toriverly/CS207Project/img/hilt_wiring.jpg

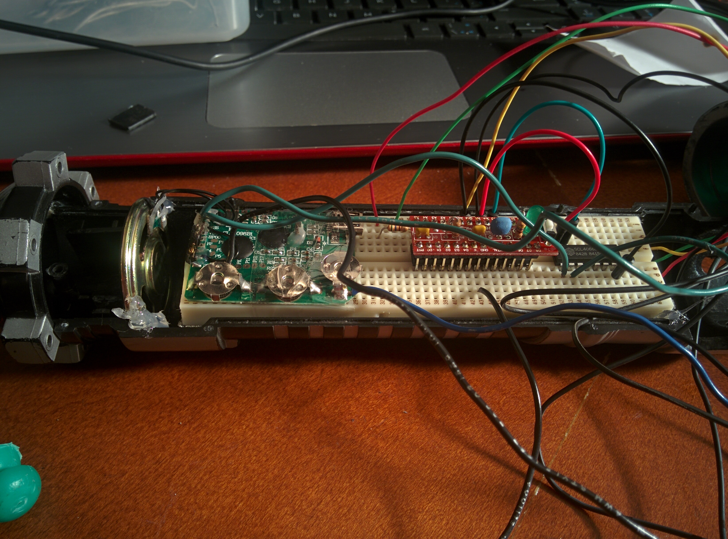
img/hilt_wiring.jpg
