toriverly/CS207Project/(commit log)

2016-12-01 Adding gyroscope test code
    Code sample by Miles Moody. Prints Wii motion plus gyroscope readings to
    serial. Updated to use current Wire read/write calls. Minor changes for
    debugging.
2016-12-01 Gyro triggers sound board
    Modified sample to get gyro to trigger soundboard on significant
    acceleration change
2016-12-01 Refactored and added other axes sensoring
